williamow/mini-scanning-microscope/(list of files, cad)

Other CAD files:
optics chassis/adjustable_collimator.ipt
optics chassis/aperature clip.ipt
optics chassis/focus mount.ipt
optics chassis/objective.ipt
optics chassis/round dichroic holder.ipt
optics chassis/scan lens.ipt
optics chassis/tactic2 chassis2.ipt
