williamow/mini-scanning-microscope/boards/LD mount pcb/LD mount.kicad_pcb

## KiCad design boards/LD mount pcb/LD mount.kicad_pcb (2025-09-03)

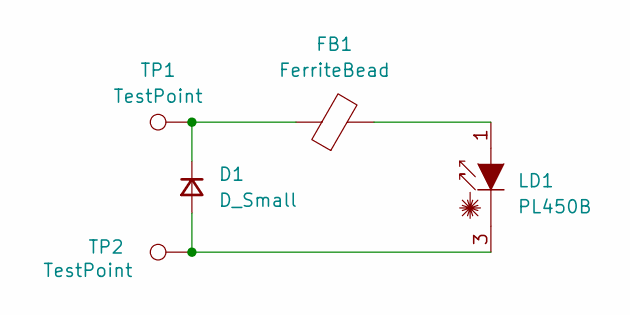
[picture p1: schematic LD mount.kicad_sch]

Parts:
D1: D_Small; D_SOD-123F
FB1: FerriteBead; L_0603_1608Metric_Pad1.05x0.95mm_HandSolder
LD1: PL450B; LaserDiode_TO38ICut-3
TP1, TP2: TestPoint; TestPoint_Pad_D2.0mm

Connections:
unnamed: D1.2 (A), LD1.3 (C), TP2.1
unnamed: D1.1 (K), FB1.1, TP1.1
unnamed: FB1.2, LD1.1 (A)

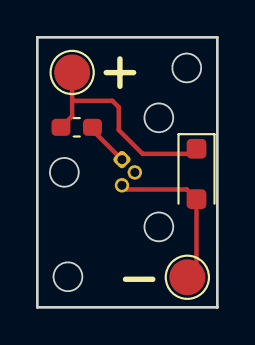
[picture p2: board LD mount.kicad_pcb from above]

Board: 2 copper layers, 10.0 x 15.0 mm, 5 parts (1 on the bottom side), 3 nets.
