williamow/mini-scanning-microscope/boards/macro system v2 pcb/controller test board.kicad_pcb

## KiCad design boards/macro system v2 pcb/controller test board.kicad_pcb (2024-10-22)

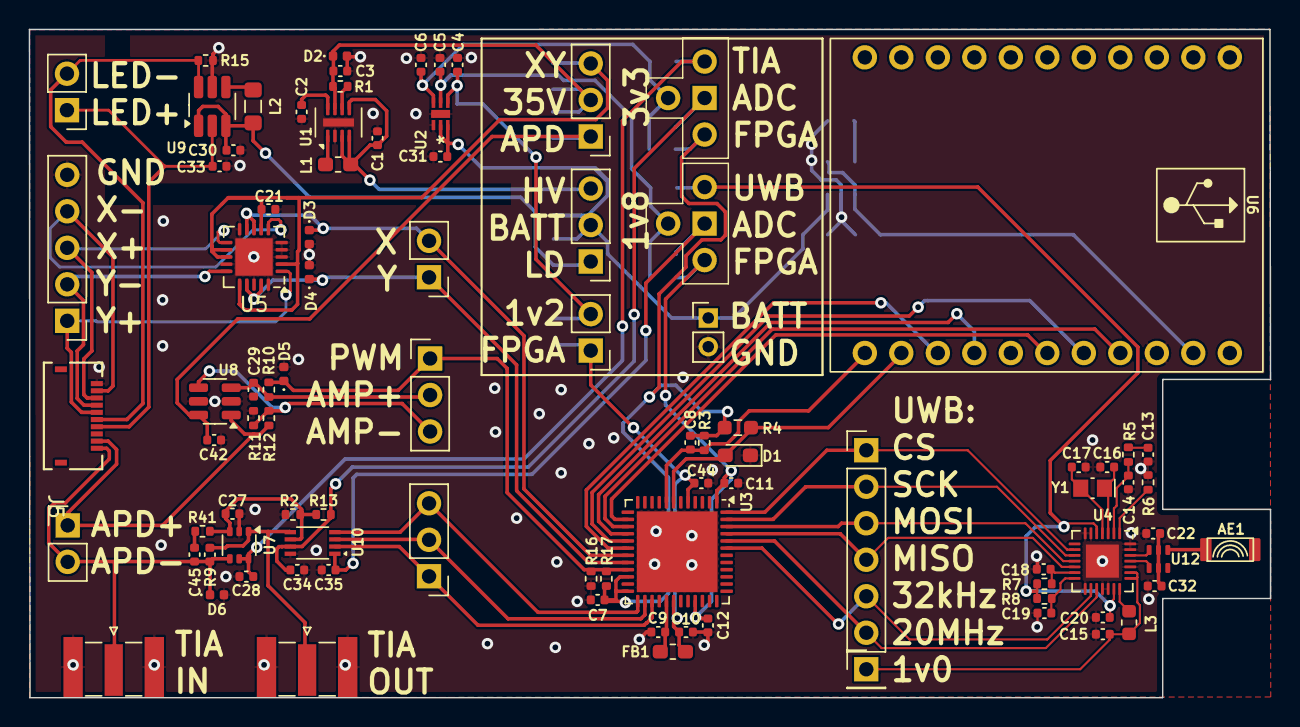
[picture p3: board boards/macro system v2 pcb/controller test board.kicad_pcb from above]

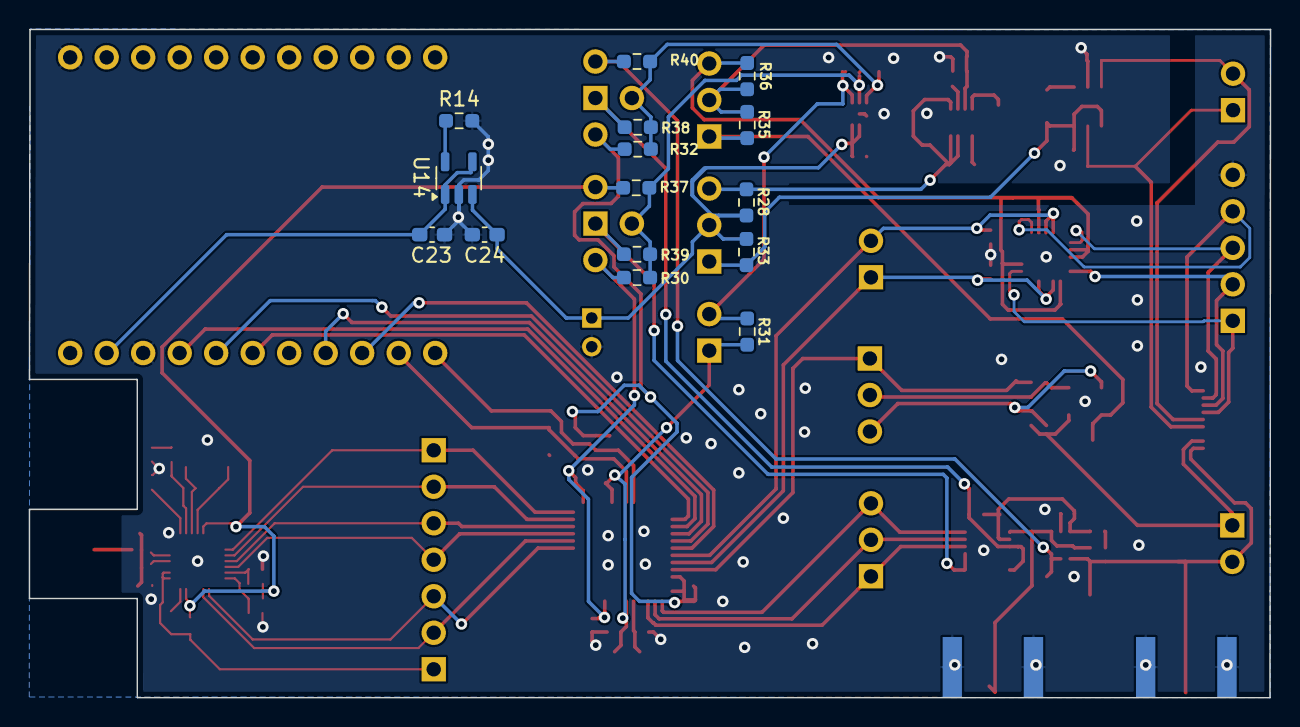
[picture p4: board boards/macro system v2 pcb/controller test board.kicad_pcb from below]

Board: 2 copper layers, 86.4 x 46.5 mm, 106 parts (15 on the bottom side), 69 nets.

Parts:
AE1: Antenna; antenna_footprint
C1, C3, C4, C5, C6, C15, C30, C31, C33: 1u; C_0402_1005Metric
C2: 0.22u; C_0402_1005Metric
C7, C9, C10, C11, C12, C18, C19, C20, C21, C22, C27, C28, C29, C32, C34, C35, C42, C44: 100n; C_0402_1005Metric
C8: 12p; C_0402_1005Metric
C13: 680p; C_0402_1005Metric
C14: 68p; C_0402_1005Metric
C16, C17: 3.9p; C_0402_1005Metric
C23, C24: 1u; C_0603_1608Metric_Pad1.08x0.95mm_HandSolder
C45: 50p; C_0402_1005Metric
D1: LED; LED_0603_1608Metric_Pad1.05x0.95mm_HandSolder
D2, D3, D4, D5, D6: D; D_0402_1005Metric
FB1: FerriteBead_Small; L_0603_1608Metric_Pad1.05x0.95mm_HandSolder
J1: Conn_01x02; PinHeader_1x02_P2.00mm_Vertical
J2, J6, J10, J11: Conn_01x03; PinHeader_1x03_P2.54mm_Vertical
J3, J14: Conn_Coaxial; SMA_Samtec_SMA-J-P-X-ST-EM1_EdgeMount
J4: Conn_01x06; PinHeader_1x06_P2.54mm_Vertical
J5: FH19C-10S-0.5SH10; CONN_FH19C-10S-0.5SH10_HIR
J7: Mirror drive; PinHeader_1x05_P2.54mm_Vertical
J8: mdrive; PinHeader_1x02_P2.54mm_Vertical
J9: APD_conn; PinHeader_1x02_P2.54mm_Vertical
J12: Conn_01x02; PinHeader_1x02_P2.54mm_Vertical
J15: LED conn; PinHeader_1x02_P2.54mm_Vertical
J16: Conn_01x01; PinHeader_1x01_P2.54mm_Vertical
L1: 15u; L_0603_1608Metric_Pad1.05x0.95mm_HandSolder
L2: 4.7u; L_0805_2012Metric_Pad1.05x1.20mm_HandSolder
L3: 180n; L_0603_1608Metric
R1: 5M; R_0402_1005Metric
R2, R10, R11, R13: 100k; R_0402_1005Metric
R3, R16, R17: 10k; R_0402_1005Metric
R4: 1k; R_0603_1608Metric_Pad0.98x0.95mm_HandSolder
R5: 390k; R_0402_1005Metric
R6: 2.2M; R_0402_1005Metric
R7: 380k; R_0402_1005Metric
R8: 0; R_0402_1005Metric
R9: TIA_FB; C_0402_1005Metric
R12: 1.2M; R_0402_1005Metric
R14: 10k; R_0603_1608Metric_Pad0.98x0.95mm_HandSolder
R15: 4.7; R_0402_1005Metric
R28, R30, R31, R32, R33, R35, R36, R37, R38, R39, R40: 1; R_0603_1608Metric_Pad0.98x0.95mm_HandSolder
R41: 50; R_0402_1005Metric
U1: LT3494; DFN-8-1EP_2x3mm_P0.5mm_EP0.56x2.15mm
U2: MIC5387-SG4YMT-TR; MLF-6_MT_MCH
U3: ICE40UP5K-SG48ITR; QFN-48-1EP_7x7mm_P0.5mm_EP5.6x5.6mm
U4: SR10x0; QFN-28-1EP_4x4mm_P0.4mm_EP2.3x2.3mm
U5: ADG5234_QFN; QFN-20-1EP_4x4mm_P0.5mm_EP2.6x2.6mm
U6: adafruit_FT232H
U7: OPA838SIDCKT; SOT-363_SC-70-6
U8: ADA4097; TSOT-23-6
U9: AP3036B; SOT-23-6_Handsoldering
U10: ADS7040xDCU; VSSOP-8_2.3x2mm_P0.5mm
U11, U13: Pin-T
U12: CSP_BALUN
U14: MCP73812T-420I-OT; SOT-23-5
Y1: 32.768kHz; Crystal_SMD_MicroCrystal_CM9V-T1A-2Pin_1.6x1.0mm_HandSolder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

Connections:
/1v2: C4.1, J12.2, R31.1, U2.4 (OUT3)
/1v8: C5.1, R30.1, R37.1, R39.2, U2.5 (OUT2), U13.3
/3v3: C6.1, R32.2, R38.2, R40.1, U2.6 (OUT1), U11.3
/35v: C3.1, D2.1 (K), J10.2, R1.2, R35.1, R36.1, U1.7 (VOUT)
/ADC/CS: J6.3, U3.25 (IOT_36b), U10.4 (~CS)
/ADC/SCLK: J6.1, U3.27 (IOT_38b), U10.2 (SCLK)
/ADC/SDO: J6.2, U3.26 (IOT_39a), U10.3 (SDO)
/ADC/ref: C27.1, R2.1, R13.1, R41.2, U7.3 (+), U10.6 (AINP)
/ADC/vin: J3.1 (In), R9.2, U7.1, U10.5 (AINM)
/ADG5234/INX: D3.1 (K), J8.2, U3.19 (IOB_29b), U5.8 (IN2), U5.9 (IN3)
/ADG5234/INY: D4.1 (K), J8.1, U3.20 (IOB_25b_G3), U5.17 (IN4), U5.19 (IN1)
/ADG5234/X+: J5.3, J7.3, U5.11 (D3)
/ADG5234/X-: J5.2, J7.4, U5.6 (D2)
/ADG5234/Y+: J5.5, J7.1, U5.1 (D1)
/ADG5234/Y-: J5.4, J7.2, U5.15 (D4)
/BATT: C24.1, C31.1, J1.1, J2.2, R28.1, R33.1, U2.2 (VIN), U2.3 (EN2/3), U14.3 (V_{BAT})
/HVbias/HV_bias: J5.9, J9.1, R12.2, U8.1
/HVbias/PWM_in: D5.1 (K), J11.1, R10.1, R16.1, R17.2, U3.21 (IOB_23b)
/ICE40UP5K/CLK_20.48M: J4.6, U3.44 (IOB_3b_G6), U4.17 (PLL_CLK)
/ICE40UP5K/CLK_32.768K: J4.5, U3.43 (IOT_49a), U4.16 (XTAL_CLK)
/ICE40UP5K/PROG_CDONE: D1.2 (A), R4.2, U3.7 (CDONE), U6.13 (CS4/D6)
/ICE40UP5K/PROG_CRESET: C8.2, R3.2, U3.8 (~CRESET), U6.12 (CS5/D7)
/ICE40UP5K/PROG_CS: U3.16 (IOB_35b_SPI_SS), U6.15 (CS2/D4)
/ICE40UP5K/PROG_CS2: U3.18 (IOB_31b), U6.14 (CS3/D5)
/ICE40UP5K/PROG_MISO: U3.14 (IOB_32a_SPI_SO), U6.17 (MISO/D2)
/ICE40UP5K/PROG_MOSI: U3.17 (IOB_33b_SPI_SI), U6.18 (MOSI/D1)
/ICE40UP5K/PROG_SCK: U3.15 (IOB_34a_SPI_SCK), U6.19 (SCK/D0)
/ICE40UP5K/UWB_CS: J4.1, U3.48 (IOB_4a), U4.9 (CSN)
/ICE40UP5K/UWB_MISO: J4.4, U3.45 (IOB_5b), U4.12 (MISO)
/ICE40UP5K/UWB_MOSI: J4.3, U3.46 (IOB_0a), U4.11 (MOSI)
/ICE40UP5K/UWB_SCK: J4.2, U3.47 (IOB_2a), U4.10 (SCK)
/I_35V_BATT: C1.1, J2.3, L1.1, R28.2, U1.3 (VCC), U1.4 (CTRL), U1.5 (EN)
/I_ADC_1V8: C35.1, R39.1, U10.1 (DVDD), U13.1
/I_ADC_3V3: C34.1, R13.2, R38.1, U10.7 (AVDD), U11.1
/I_FPGA_1V2: C10.1, C44.1, FB1.1, J12.1, R31.2, U3.5 (VCC), U3.30 (VCC)
/I_FPGA_1V8: C11.1, C12.1, R30.2, U3.1 (VCCIO_2), U3.33 (VCCIO_0), U13.4
/I_FPGA_3V3: C7.1, C8.1, R3.1, R4.1, R17.1, R32.1, U3.22 (SPI_VCCIO1), U3.24 (VPP_2V5), U11.4
/I_LED_BATT: C30.1, J2.1, L2.2, R33.2, U9.1 (EN), U9.3 (VIN)
/I_MIRROR_35V: C21.1, J10.3, R36.2, U5.2 (S1B), U5.7 (S2A), U5.12 (S3B), U5.13 (VDD), U5.16 (S4A)
/I_SPAD_35V: C42.1, J10.1, R35.2, U8.6 (V+)
/I_TIA_3V3: C28.1, R40.2, U7.5 (~DISABLE), U7.6 (V+), U11.2
/I_UWB_1V8: C20.1, R7.2, R8.1, R37.2, U4.5 (AVDD_3V), U4.20 (DVDD_3V), U13.2
/LED_driver/LED+: C33.1, J5.7, J15.1, U9.2 (VOUT)
/LED_driver/LED-: J5.6, J15.2, R15.2, U9.6 (FB)
/LT3494_boost/FB: R1.1, U1.6 (FB)
/SR1010_UWB/RFN: U4.25 (RFN), U12.4 (DIFFP)
/SR1010_UWB/RFP: U4.26 (RFP), U12.3 (DIFFN)
/TIA/I_APD: C45.2, D6.1 (K), J5.10, J9.2, J14.1 (In), R9.1, U7.4 (-)
GND: C1.2, C2.2, C3.2, C4.2, C5.2, C6.2, C7.2, C9.2, C10.2, C11.2, C12.2, C13.2, C14.2, C15.2, C16.2, C17.2, C18.2, C19.2, C20.2, C21.2, C22.2, C23.2, C24.2, C27.2, C28.2, C29.2, C30.2, C31.2, C32.2, C33.2, C34.2, C35.2, C42.2, C44.2, D1.1 (K), D2.2 (A), D3.2 (A), D4.2 (A), D5.2 (A), D6.2 (A), J1.2, J3.2 (Ext), J5.1, J7.5, J14.2 (Ext), R2.2, R6.1, R11.1, R14.1, R15.1, R16.2, U1.2 (GND), U1.9 (PAD), U2.1 (GND), U2.7 (PAD), U3.49 (GND), U4.6 (GND), U4.7 (SHUTDOWN), U4.15 (DVDD_NVM), U4.18 (SCAN_EN), U4.19 (DBG_EN), U4.24 (GND), U4.27 (GND), U4.28 (GND), U4.29 (PAD), U5.3 (VSS), U5.4 (GND), U5.5 (S2B), U5.10 (S3A), U5.14 (S4B), U5.18 (ENn), U5.20 (S1A), U5.21 (EP), U6.1 (GND), U6.20 (GND), U7.2 (V-), U8.2 (V-), U8.5 (~DISABLE), U9.5 (GND), U10.8 (GND), U14.2 (V_{SS})
unnamed: AE1.1 (A), U12.1 (SE(50))
unnamed: C13.1, R5.1
unnamed: C22.1, C32.1, U12.2 (GND), U12.5 (GND)
unnamed: C45.1, R41.1
unnamed: C29.1, J11.2, R10.2, U8.3 (+)
unnamed: J11.3, R11.2, R12.1, U8.4 (-)
unnamed: C15.1, J16.1, L3.1, U4.22 (DVDD_1V), U4.23 (AVDD_1V)
unnamed: C2.1, U1.8 (CAP)
unnamed: L1.2, U1.1 (SW)
unnamed: C9.1, FB1.2, U3.29 (VCCPLL)
unnamed: R6.2, U4.1 (BIAS)
unnamed: C19.1, R8.2, U4.14 (DVDD_1V8)
unnamed: C14.1, R5.2, U4.2 (PLL_TUNE)
unnamed: L3.2, U4.21 (REG_OUT)
unnamed: C18.1, R7.1, U4.13 (RSTN)
unnamed: C16.1, U4.3 (XTAL_C1), Y1.1
unnamed: C17.1, U4.4 (XTAL_C2), Y1.2
unnamed: L2.1, U9.4 (SW)
unnamed: C23.1, U6.21 (5V), U14.1 (CE), U14.4 (V_{DD})
unnamed: R14.2, U14.5 (PROG)
