williamow/mini-scanning-microscope/boards/LD APD M mount pcb/LD APD M mount.kicad_pcb

## KiCad design boards/LD APD M mount pcb/LD APD M mount.kicad_pcb (2024-10-22)

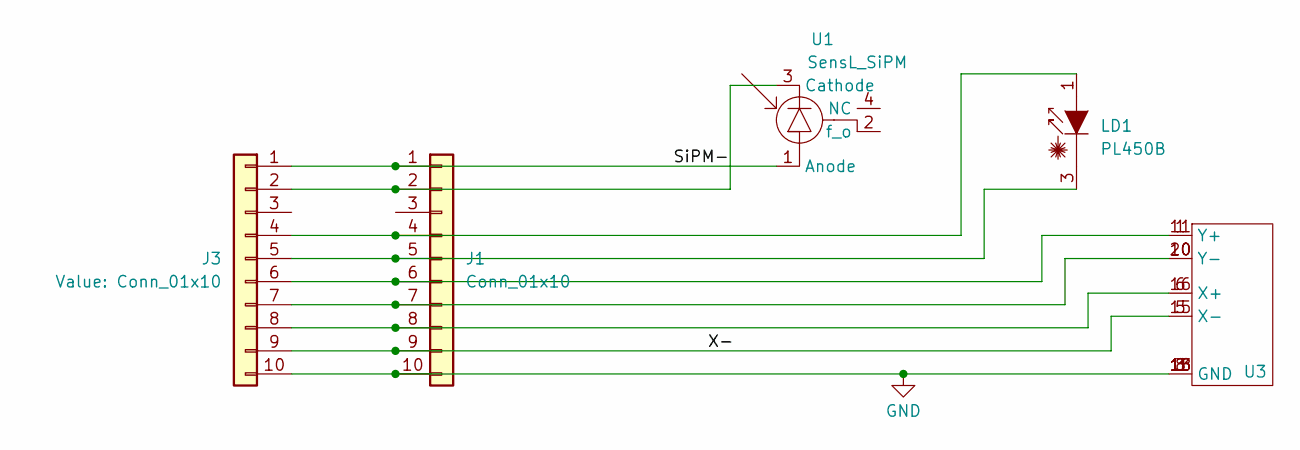
[picture p5: schematic LD APD M mount.kicad_sch]

Parts:
J1: Conn_01x10; PinHeader_1x10_P2.54mm_Vertical
J3: Conn_01x10; FH19C_Connector
LD1: PL450B; LaserDiode_TO38ICut-3
U1: SensL_SiPM; SensL_SiPM_6mm
U3: PLCC-20

Connections:
/SiPM-: J1.1, J3.1, U1.1 (Anode)
/X-: J1.9, J3.9, U3.5 (X-), U3.15 (X-)
GND: J1.10, J3.10, U3.3 (GND), U3.8 (GND), U3.13 (GND), U3.18 (GND)
unnamed: J1.2, J3.2, U1.3 (Cathode)
unnamed: J1.4, J3.4, LD1.1 (A)
unnamed: J1.5, J3.5, LD1.3 (C)
unnamed: J1.6, J3.6, U3.1 (Y+), U3.11 (Y+)
unnamed: J1.7, J3.7, U3.10 (Y-), U3.20 (Y-)
unnamed: J1.8, J3.8, U3.6 (X+), U3.16 (X+)

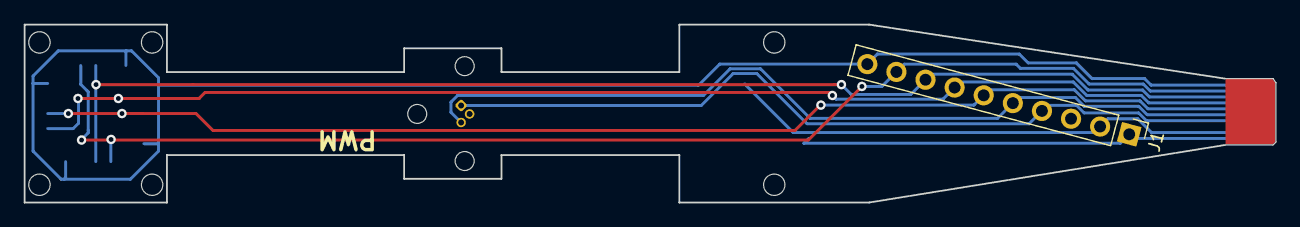
[picture p6: board LD APD M mount.kicad_pcb from above]

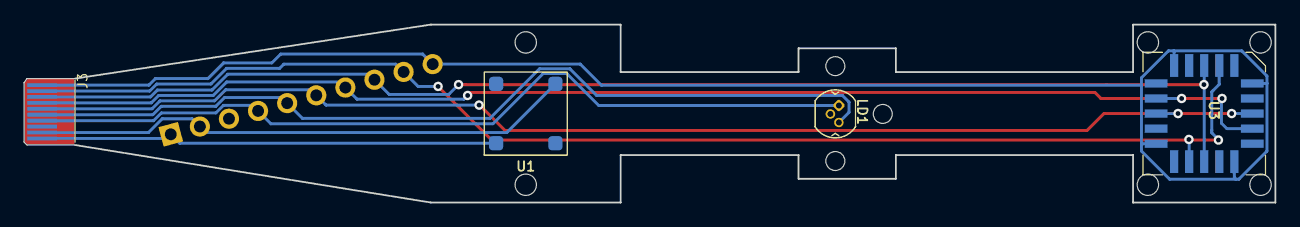
[picture p7: board LD APD M mount.kicad_pcb from below]

Board: 2 copper layers, 105.5 x 15.0 mm, 5 parts (4 on the bottom side), 9 nets.
