williamow/mini-scanning-microscope/boards/UWB antenna test pcb/UWB_antenna_tests.kicad_pcb

## KiCad design boards/UWB antenna test pcb/UWB_antenna_tests.kicad_pcb (2024-07-01)

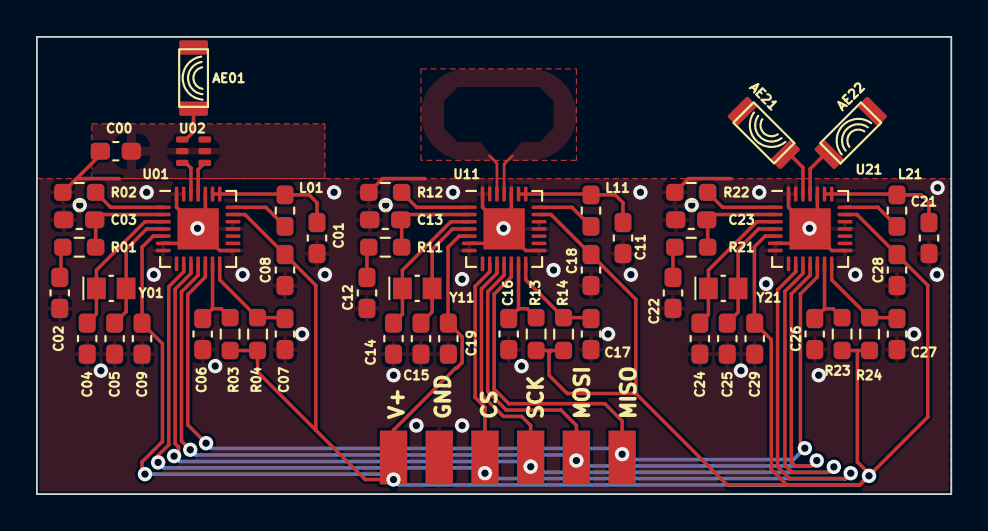
[picture p8: board UWB_antenna_tests.kicad_pcb from above]

Board: 2 copper layers, 50.8 x 25.4 mm, 59 parts (0 on the bottom side), 40 nets.

Parts:
AE01, AE21, AE22: Antenna; antenna_footprint
C00, C06, C07, C08, C09, C16, C17, C18, C19, C26, C27, C28, C29: 100n; C_0603_1608Metric_Pad1.08x0.95mm_HandSolder
C01, C11, C21: 1u; C_0603_1608Metric_Pad1.08x0.95mm_HandSolder
C02, C12, C22: 680p; C_0603_1608Metric_Pad1.08x0.95mm_HandSolder
C03, C13, C23: 68p; C_0603_1608Metric_Pad1.08x0.95mm_HandSolder
C04, C05, C14, C15, C24, C25: 3.9p; C_0603_1608Metric_Pad1.08x0.95mm_HandSolder
J1, J2, J3, J4, J5, J6: Conn_01x01; modular_pinhead_SMD
L01, L11, L21: 180n; L_0603_1608Metric_Pad1.05x0.95mm_HandSolder
R01, R11, R21: 390k; R_0603_1608Metric_Pad0.98x0.95mm_HandSolder
R02, R12, R22: 2.2M; R_0603_1608Metric_Pad0.98x0.95mm_HandSolder
R03, R13, R23: 380k; R_0603_1608Metric_Pad0.98x0.95mm_HandSolder
R04, R14, R24: 0; R_0603_1608Metric_Pad0.98x0.95mm_HandSolder
U01, U11, U21: SR10x0; QFN-28-1EP_4x4mm_P0.4mm_EP2.3x2.3mm
U02: CSP_BALUN
Y01, Y11, Y21: 32.768kHz; Crystal_SMD_MicroCrystal_CM9V-T1A-2Pin_1.6x1.0mm_HandSolder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

Connections:
/UWB radio cap coupled1/1v8: C08.1, C09.1, C18.1, C19.1, C28.1, C29.1, J1.1, R03.2, R04.1, R13.2, R14.1, R23.2, R24.1, U01.5 (AVDD_3V), U01.20 (DVDD_3V), U11.5 (AVDD_3V), U11.20 (DVDD_3V), U21.5 (AVDD_3V), U21.20 (DVDD_3V)
/UWB radio cap coupled1/CS: J6.1, U01.9 (CSN), U11.9 (CSN), U21.9 (CSN)
/UWB radio cap coupled1/MISO: J5.1, U01.12 (MISO), U11.12 (MISO), U21.12 (MISO)
/UWB radio cap coupled1/MOSI: J3.1, U01.11 (MOSI), U11.11 (MOSI), U21.11 (MOSI)
/UWB radio cap coupled1/RFN: U01.25 (RFN), U02.4 (DIFFP)
/UWB radio cap coupled1/RFP: U01.26 (RFP), U02.3 (DIFFN)
/UWB radio cap coupled1/SCK: J4.1, U01.10 (SCK), U11.10 (SCK), U21.10 (SCK)
/UWB radio cap coupled2/RFN: U11.25 (RFN), U11.26 (RFP)
/UWB radio cap coupled3/RFN: AE22.1 (A), U21.25 (RFN)
/UWB radio cap coupled3/RFP: AE21.1 (A), U21.26 (RFP)
GND: C00.2, C01.2, C02.2, C03.2, C04.2, C05.2, C06.2, C07.2, C08.2, C09.2, C11.2, C12.2, C13.2, C14.2, C15.2, C16.2, C17.2, C18.2, C19.2, C21.2, C22.2, C23.2, C24.2, C25.2, C26.2, C27.2, C28.2, C29.2, J2.1, R02.1, R12.1, R22.1, U01.6 (GND), U01.7 (SHUTDOWN), U01.15 (DVDD_NVM), U01.18 (SCAN_EN), U01.19 (DBG_EN), U01.24 (GND), U01.27 (GND), U01.28 (GND), U01.29 (PAD), U11.6 (GND), U11.7 (SHUTDOWN), U11.15 (DVDD_NVM), U11.18 (SCAN_EN), U11.19 (DBG_EN), U11.24 (GND), U11.27 (GND), U11.28 (GND), U11.29 (PAD), U21.6 (GND), U21.7 (SHUTDOWN), U21.15 (DVDD_NVM), U21.18 (SCAN_EN), U21.19 (DBG_EN), U21.24 (GND), U21.27 (GND), U21.28 (GND), U21.29 (PAD)
unnamed: AE01.1 (A), U02.1 (SE(50))
unnamed: C00.1, U02.2 (GND), U02.5 (GND)
unnamed: C01.1, L01.1, U01.22 (DVDD_1V), U01.23 (AVDD_1V)
unnamed: C02.1, R01.1
unnamed: C03.1, R01.2, U01.2 (PLL_TUNE)
unnamed: C04.1, U01.3 (XTAL_C1), Y01.1
unnamed: C05.1, U01.4 (XTAL_C2), Y01.2
unnamed: C06.1, R03.1, U01.13 (RSTN)
unnamed: C07.1, R04.2, U01.14 (DVDD_1V8)
unnamed: C11.1, L11.1, U11.22 (DVDD_1V), U11.23 (AVDD_1V)
unnamed: C12.1, R11.1
unnamed: C13.1, R11.2, U11.2 (PLL_TUNE)
unnamed: C14.1, U11.3 (XTAL_C1), Y11.1
unnamed: C15.1, U11.4 (XTAL_C2), Y11.2
unnamed: C16.1, R13.1, U11.13 (RSTN)
unnamed: C17.1, R14.2, U11.14 (DVDD_1V8)
unnamed: C21.1, L21.1, U21.22 (DVDD_1V), U21.23 (AVDD_1V)
unnamed: C22.1, R21.1
unnamed: C23.1, R21.2, U21.2 (PLL_TUNE)
unnamed: C24.1, U21.3 (XTAL_C1), Y21.1
unnamed: C25.1, U21.4 (XTAL_C2), Y21.2
unnamed: C26.1, R23.1, U21.13 (RSTN)
unnamed: C27.1, R24.2, U21.14 (DVDD_1V8)
unnamed: L01.2, U01.21 (REG_OUT)
unnamed: L11.2, U11.21 (REG_OUT)
unnamed: L21.2, U21.21 (REG_OUT)
unnamed: R02.2, U01.1 (BIAS)
unnamed: R12.2, U11.1 (BIAS)
unnamed: R22.2, U21.1 (BIAS)
