williamow/mini-scanning-microscope/boards/macro system pcb/controller test board.kicad_pcb

## KiCad design boards/macro system pcb/controller test board.kicad_pcb (2024-07-01, an earlier design)

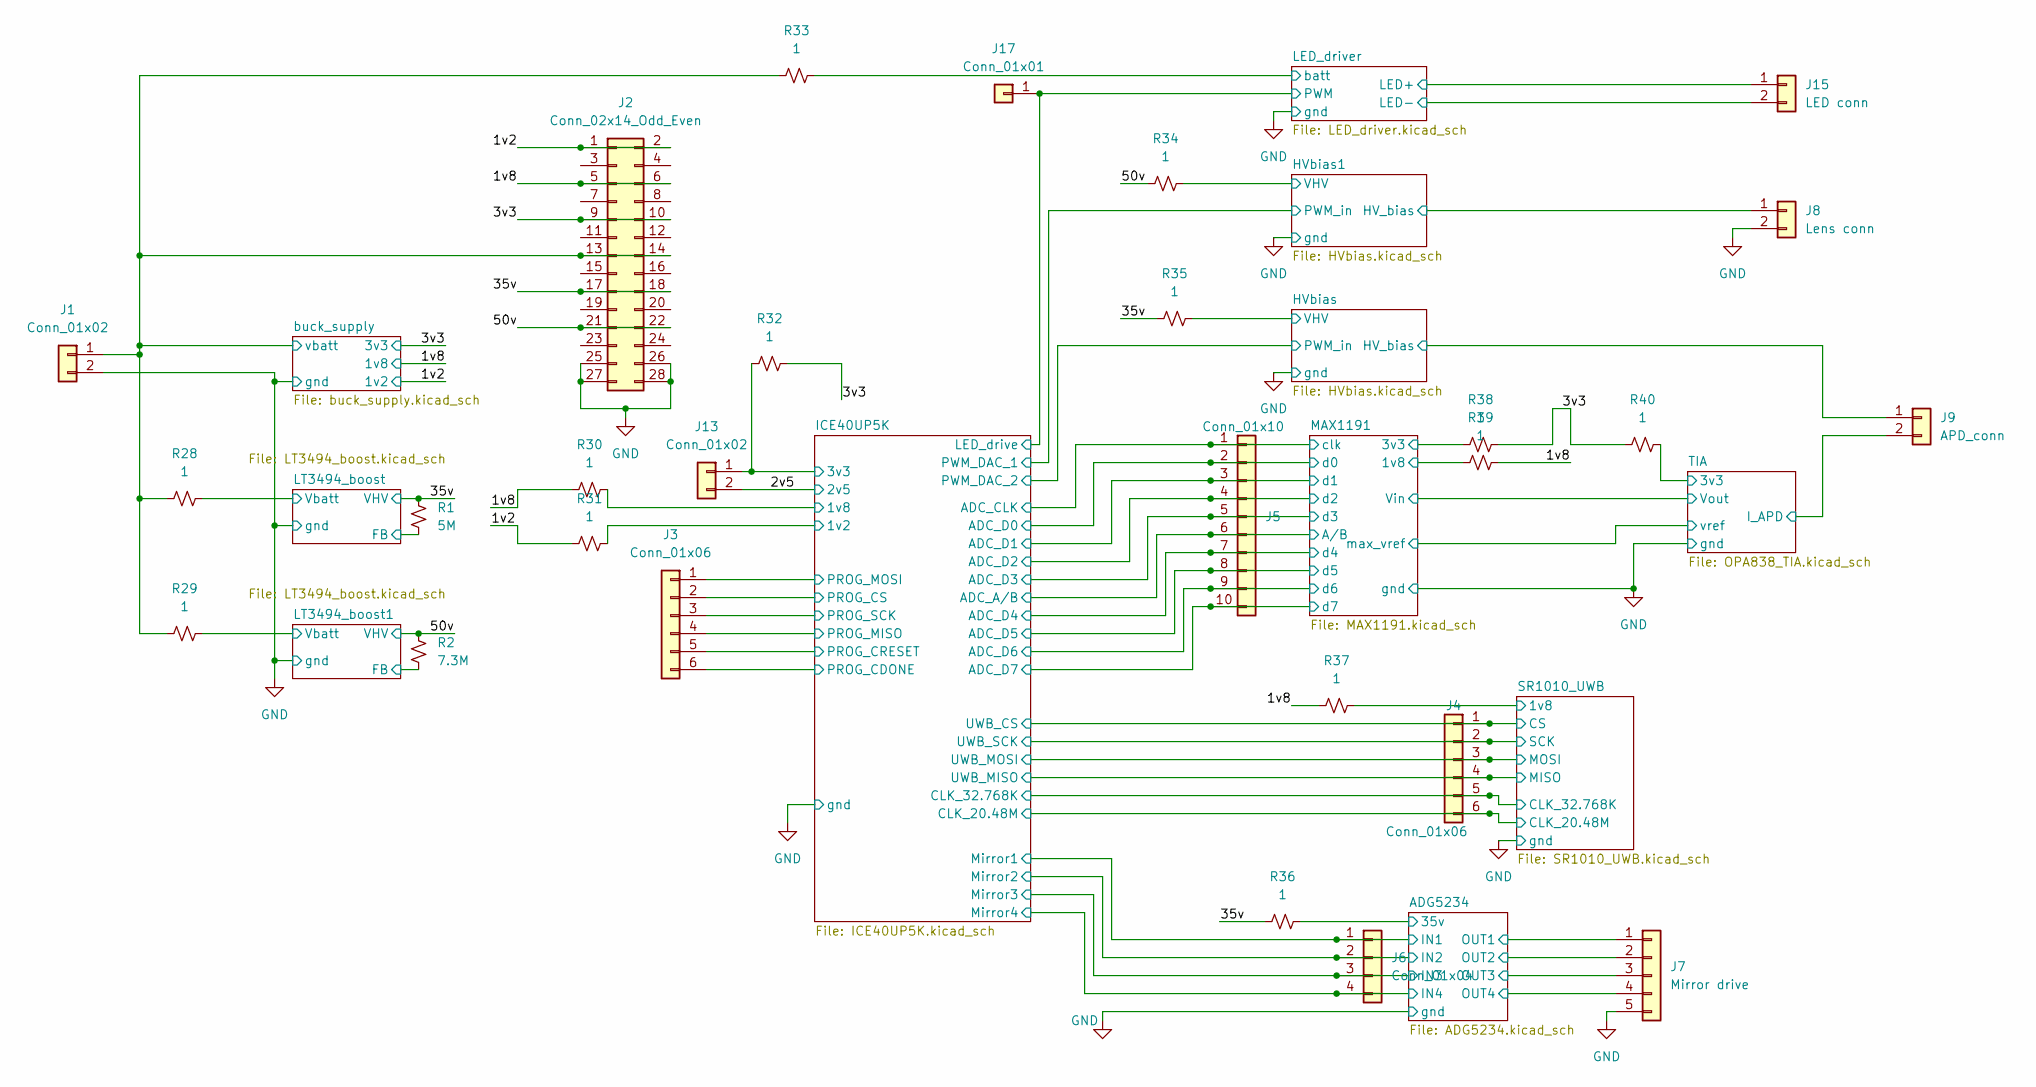
[picture p9: schematic controller test board.kicad_sch]

Parts:
J1, J13: Conn_01x02; PinHeader_1x02_P2.54mm_Vertical
J2: Conn_02x14_Odd_Even; PinHeader_2x14_P2.54mm_Vertical
J3, J4: Conn_01x06; PinHeader_1x06_P2.54mm_Vertical
J5: Conn_01x10; PinHeader_1x10_P2.54mm_Vertical
J6: Conn_01x04; PinHeader_1x04_P2.54mm_Vertical
J7: Mirror drive; PinHeader_1x05_P2.54mm_Vertical
J8: Lens conn; PinHeader_1x02_P2.54mm_Vertical
J9: APD_conn; PinHeader_1x02_P2.54mm_Vertical
J15: LED conn; PinHeader_1x02_P2.54mm_Vertical
J17: Conn_01x01; PinHeader_1x01_P2.54mm_Vertical
R1: 5M; R_0603_1608Metric_Pad0.98x0.95mm_HandSolder
R2: 7.3M; R_0603_1608Metric_Pad0.98x0.95mm_HandSolder
R28, R29, R30, R31, R32, R33, R34, R35, R36, R37, R38, R39, R40: 1; R_0603_1608Metric_Pad0.98x0.95mm_HandSolder

Connections:
/1v2: J2.1, J2.2, R31.1; also elsewhere on the board
/1v8: J2.5, J2.6, R30.1, R37.1, R39.2; also elsewhere on the board
/2v5: J13.2; also elsewhere on the board
/3v3: J2.9, J2.10, R32.2, R38.2, R40.1; also elsewhere on the board
/35v: J2.17, J2.18, R1.2, R35.1, R36.1; also elsewhere on the board
/50v: J2.21, J2.22, R2.2, R34.1; also elsewhere on the board
/ADG5234/35v: R36.2; also elsewhere on the board
/ADG5234/IN1: J6.1; also elsewhere on the board
/ADG5234/IN2: J6.2; also elsewhere on the board
/ADG5234/IN3: J6.3; also elsewhere on the board
/ADG5234/IN4: J6.4; also elsewhere on the board
/ADG5234/OUT1: J7.1; also elsewhere on the board
/ADG5234/OUT2: J7.2; also elsewhere on the board
/ADG5234/OUT3: J7.3; also elsewhere on the board
/ADG5234/OUT4: J7.4; also elsewhere on the board
/HVbias1/HV_bias: J8.1; also elsewhere on the board
/HVbias1/VHV: R34.2; also elsewhere on the board
/HVbias/HV_bias: J9.1; also elsewhere on the board
/HVbias/VHV: R35.2; also elsewhere on the board
/ICE40UP5K/1v2: R31.2; also elsewhere on the board
/ICE40UP5K/1v8: R30.2; also elsewhere on the board
/ICE40UP5K/3v3: J13.1, R32.1; also elsewhere on the board
/ICE40UP5K/ADC_A/B: J5.6; also elsewhere on the board
/ICE40UP5K/ADC_CLK: J5.1; also elsewhere on the board
/ICE40UP5K/ADC_D0: J5.2; also elsewhere on the board
/ICE40UP5K/ADC_D1: J5.3; also elsewhere on the board
/ICE40UP5K/ADC_D2: J5.4; also elsewhere on the board
/ICE40UP5K/ADC_D3: J5.5; also elsewhere on the board
/ICE40UP5K/ADC_D4: J5.7; also elsewhere on the board
/ICE40UP5K/ADC_D5: J5.8; also elsewhere on the board
/ICE40UP5K/ADC_D6: J5.9; also elsewhere on the board
/ICE40UP5K/ADC_D7: J5.10; also elsewhere on the board
/ICE40UP5K/CLK_20.48M: J4.6; also elsewhere on the board
/ICE40UP5K/CLK_32.768K: J4.5; also elsewhere on the board
/ICE40UP5K/LED_drive: J17.1; also elsewhere on the board
/ICE40UP5K/PROG_CDONE: J3.6; also elsewhere on the board
/ICE40UP5K/PROG_CRESET: J3.5; also elsewhere on the board
/ICE40UP5K/PROG_CS: J3.2; also elsewhere on the board
/ICE40UP5K/PROG_MISO: J3.4; also elsewhere on the board
/ICE40UP5K/PROG_MOSI: J3.1; also elsewhere on the board
/ICE40UP5K/PROG_SCK: J3.3; also elsewhere on the board
/ICE40UP5K/UWB_CS: J4.1; also elsewhere on the board
/ICE40UP5K/UWB_MISO: J4.4; also elsewhere on the board
/ICE40UP5K/UWB_MOSI: J4.3; also elsewhere on the board
/ICE40UP5K/UWB_SCK: J4.2; also elsewhere on the board
/LED_driver/LED+: J15.1; also elsewhere on the board
/LED_driver/LED-: J15.2; also elsewhere on the board
/LED_driver/batt: R33.2; also elsewhere on the board
/LT3494_boost1/FB: R2.1; also elsewhere on the board
/LT3494_boost1/Vbatt: R29.2; also elsewhere on the board
/LT3494_boost/FB: R1.1; also elsewhere on the board
/LT3494_boost/Vbatt: R28.2; also elsewhere on the board
/MAX1191/1v8: R39.1; also elsewhere on the board
/MAX1191/3v3: R38.1; also elsewhere on the board
/SR1010_UWB/1v8: R37.2; also elsewhere on the board
/TIA/3v3: R40.2; also elsewhere on the board
/TIA/I_APD: J9.2; also elsewhere on the board
/buck_supply/vbatt: J1.1, J2.13, J2.14, R28.1, R29.1, R33.1; also elsewhere on the board
GND: J1.2, J2.25, J2.26, J2.27, J2.28, J7.5, J8.2; also elsewhere on the board

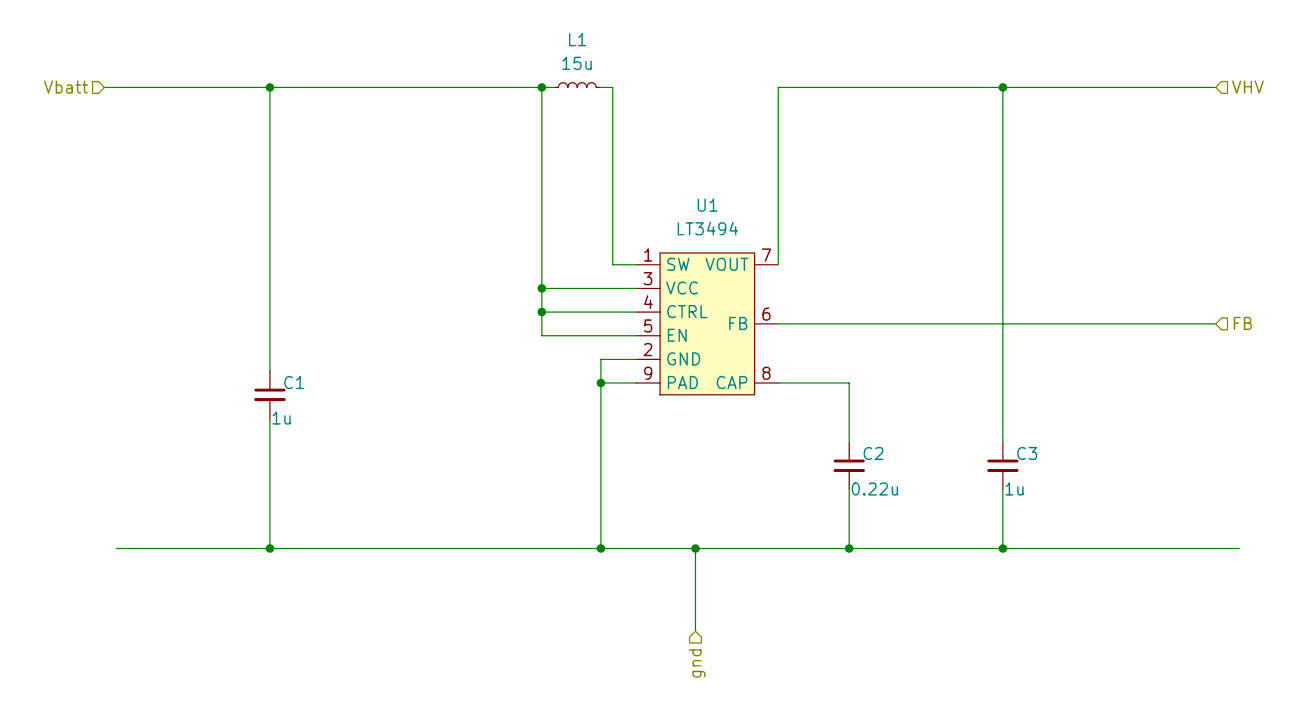
[picture p10: schematic LT3494_boost.kicad_sch]

Parts:
C1, C3: 1u; C_0603_1608Metric_Pad1.08x0.95mm_HandSolder
C2: 0.22u; C_0603_1608Metric_Pad1.08x0.95mm_HandSolder
L1: 15u; L_0603_1608Metric_Pad1.05x0.95mm_HandSolder
U1: LT3494; DFN-8-1EP_2x3mm_P0.5mm_EP0.56x2.15mm

Connections:
/35v: C3.1, U1.7 (VOUT); also elsewhere on the board
/LT3494_boost/FB: U1.6 (FB); also elsewhere on the board
/LT3494_boost/Vbatt: C1.1, L1.1, U1.3 (VCC), U1.4 (CTRL), U1.5 (EN); also elsewhere on the board
GND: C1.2, C2.2, C3.2, U1.2 (GND), U1.9 (PAD); also elsewhere on the board
unnamed: C2.1, U1.8 (CAP)
unnamed: L1.2, U1.1 (SW)

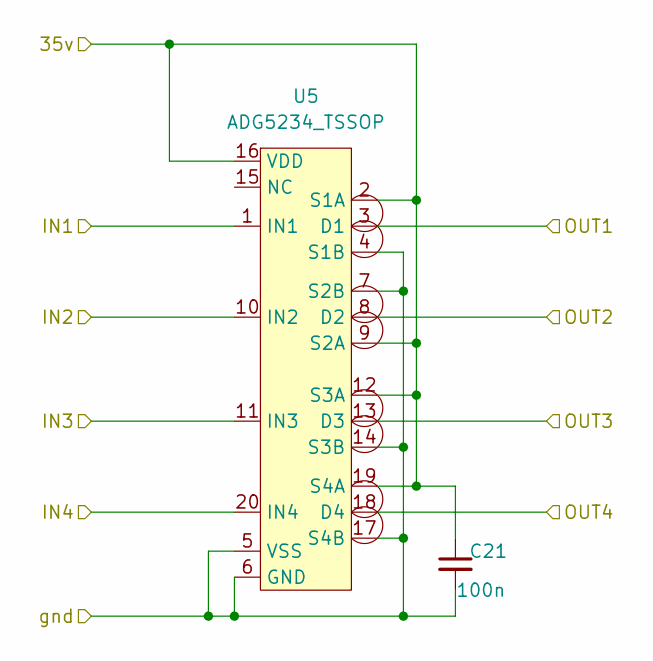
[picture p11: schematic ADG5234.kicad_sch]

Parts:
C21: 100n; C_0603_1608Metric_Pad1.08x0.95mm_HandSolder
U5: ADG5234_TSSOP; TSSOP-20_4.4x6.5mm_P0.65mm

Connections:
/ADG5234/35v: C21.1, U5.2 (S1A), U5.9 (S2A), U5.12 (S3A), U5.16 (VDD), U5.19 (S4A); also elsewhere on the board
/ADG5234/IN1: U5.1 (IN1); also elsewhere on the board
/ADG5234/IN2: U5.10 (IN2); also elsewhere on the board
/ADG5234/IN3: U5.11 (IN3); also elsewhere on the board
/ADG5234/IN4: U5.20 (IN4); also elsewhere on the board
/ADG5234/OUT1: U5.3 (D1); also elsewhere on the board
/ADG5234/OUT2: U5.8 (D2); also elsewhere on the board
/ADG5234/OUT3: U5.13 (D3); also elsewhere on the board
/ADG5234/OUT4: U5.18 (D4); also elsewhere on the board
GND: C21.2, U5.4 (S1B), U5.5 (VSS), U5.6 (GND), U5.7 (S2B), U5.14 (S3B), U5.17 (S4B); also elsewhere on the board

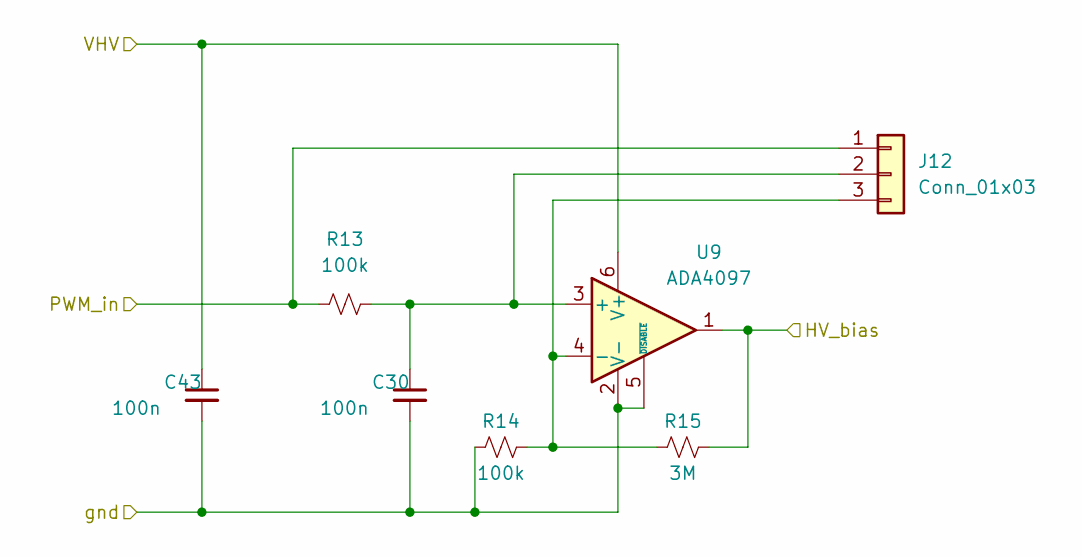
[picture p12: schematic HVbias.kicad_sch]

Parts:
C30, C43: 100n; C_0603_1608Metric_Pad1.08x0.95mm_HandSolder
J12: Conn_01x03; PinHeader_1x03_P2.54mm_Vertical
R13, R14: 100k; R_0603_1608Metric_Pad0.98x0.95mm_HandSolder
R15: 3M; R_0603_1608Metric_Pad0.98x0.95mm_HandSolder
U9: ADA4097; TSOT-23-6_HandSoldering

Connections:
/HVbias1/HV_bias: R15.2, U9.1; also elsewhere on the board
/HVbias1/PWM_in: J12.1, R13.1; also elsewhere on the board
/HVbias1/VHV: C43.1, U9.6 (V+); also elsewhere on the board
GND: C30.2, C43.2, R14.1, U9.2 (V-), U9.5 (~DISABLE); also elsewhere on the board
unnamed: C30.1, J12.2, R13.2, U9.3 (+)
unnamed: J12.3, R14.2, R15.1, U9.4 (-)

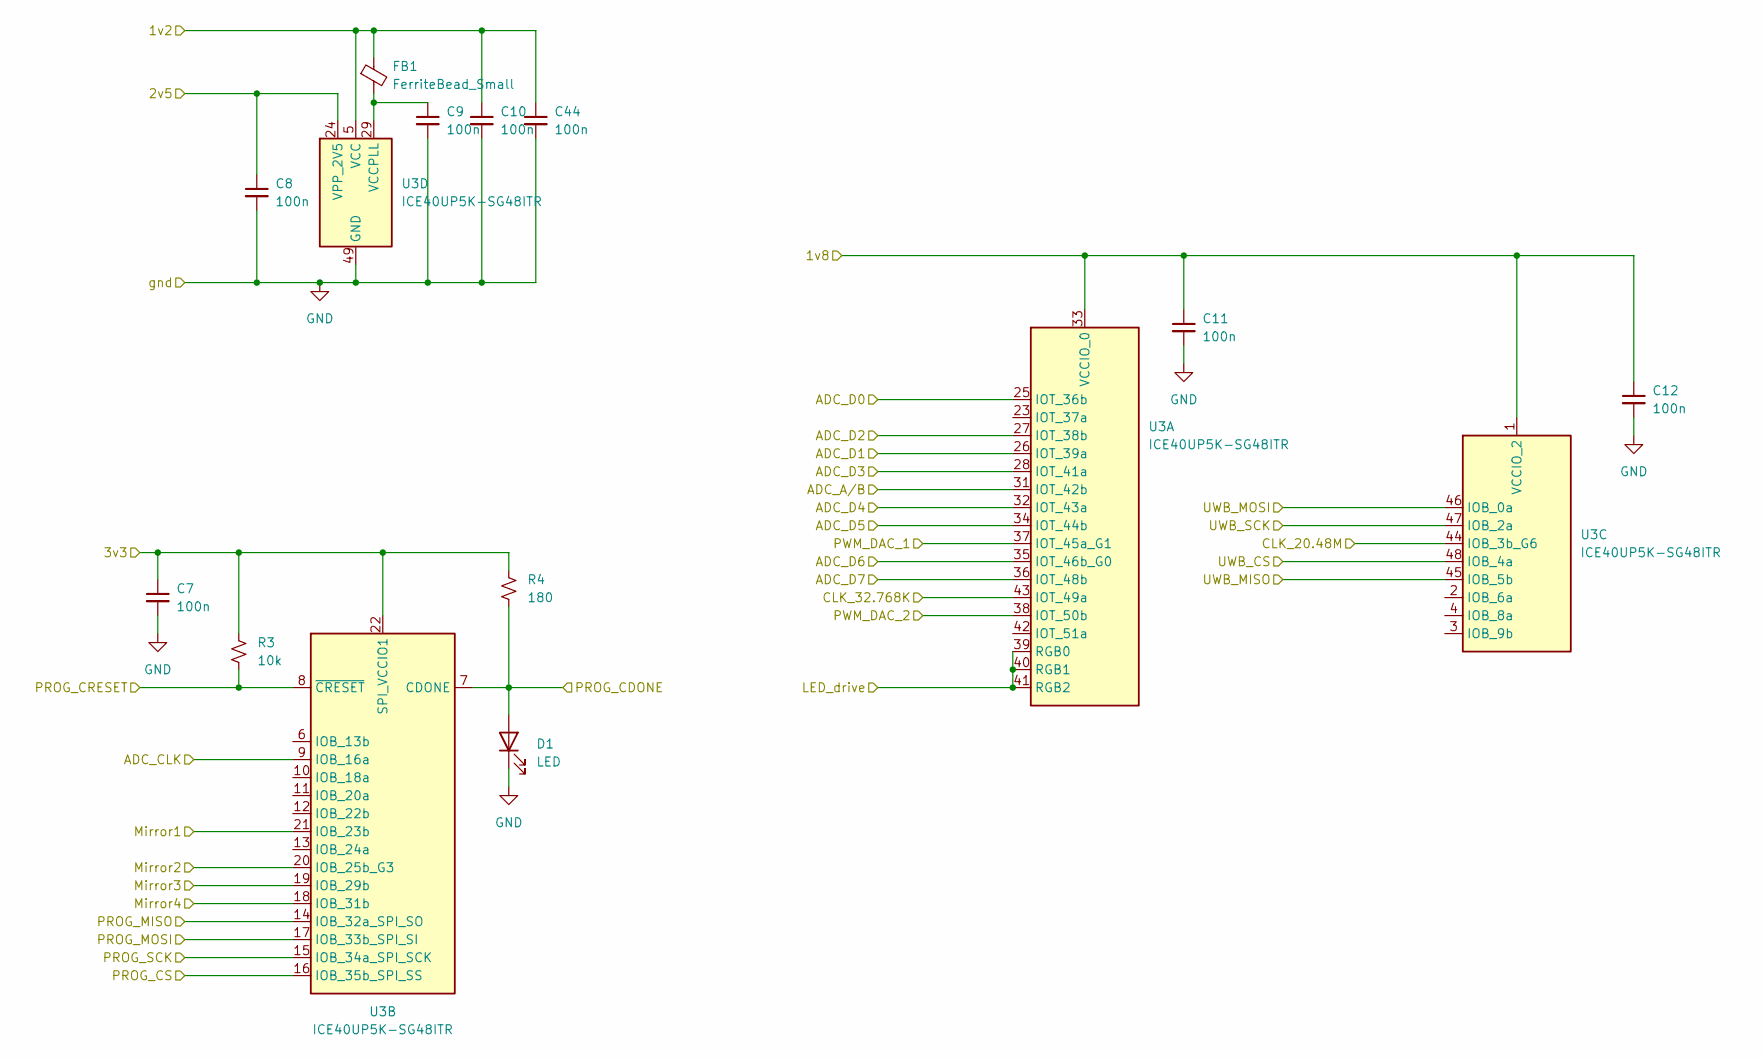
[picture p13: schematic ICE40UP5K.kicad_sch]

Parts:
C7, C8, C9, C10, C11, C12, C44: 100n; C_0603_1608Metric_Pad1.08x0.95mm_HandSolder
D1: LED; LED_0603_1608Metric_Pad1.05x0.95mm_HandSolder
FB1: FerriteBead_Small; L_0603_1608Metric_Pad1.05x0.95mm_HandSolder
R3: 10k; R_0603_1608Metric_Pad0.98x0.95mm_HandSolder
R4: 180; R_0603_1608Metric_Pad0.98x0.95mm_HandSolder
U3: ICE40UP5K-SG48ITR; QFN-48-1EP_7x7mm_P0.5mm_EP5.6x5.6mm

Connections:
/2v5: C8.1, U3.24 (VPP_2V5); also elsewhere on the board
/ADG5234/IN1: U3.21 (IOB_23b); also elsewhere on the board
/ADG5234/IN2: U3.20 (IOB_25b_G3); also elsewhere on the board
/ADG5234/IN3: U3.19 (IOB_29b); also elsewhere on the board
/ADG5234/IN4: U3.18 (IOB_31b); also elsewhere on the board
/HVbias1/PWM_in: U3.37 (IOT_45a_G1); also elsewhere on the board
/HVbias/PWM_in: U3.38 (IOT_50b); also elsewhere on the board
/ICE40UP5K/1v2: C10.1, C44.1, FB1.1, U3.5 (VCC), U3.30 (VCC); also elsewhere on the board
/ICE40UP5K/1v8: C11.1, C12.1, U3.1 (VCCIO_2), U3.33 (VCCIO_0); also elsewhere on the board
/ICE40UP5K/3v3: C7.1, R3.1, R4.1, U3.22 (SPI_VCCIO1); also elsewhere on the board
/ICE40UP5K/ADC_A/B: U3.31 (IOT_42b); also elsewhere on the board
/ICE40UP5K/ADC_CLK: U3.9 (IOB_16a); also elsewhere on the board
/ICE40UP5K/ADC_D0: U3.25 (IOT_36b); also elsewhere on the board
/ICE40UP5K/ADC_D1: U3.26 (IOT_39a); also elsewhere on the board
/ICE40UP5K/ADC_D2: U3.27 (IOT_38b); also elsewhere on the board
/ICE40UP5K/ADC_D3: U3.28 (IOT_41a); also elsewhere on the board
/ICE40UP5K/ADC_D4: U3.32 (IOT_43a); also elsewhere on the board
/ICE40UP5K/ADC_D5: U3.34 (IOT_44b); also elsewhere on the board
/ICE40UP5K/ADC_D6: U3.35 (IOT_46b_G0); also elsewhere on the board
/ICE40UP5K/ADC_D7: U3.36 (IOT_48b); also elsewhere on the board
/ICE40UP5K/CLK_20.48M: U3.44 (IOB_3b_G6); also elsewhere on the board
/ICE40UP5K/CLK_32.768K: U3.43 (IOT_49a); also elsewhere on the board
/ICE40UP5K/LED_drive: U3.39 (RGB0), U3.40 (RGB1), U3.41 (RGB2); also elsewhere on the board
/ICE40UP5K/PROG_CDONE: D1.2 (A), R4.2, U3.7 (CDONE); also elsewhere on the board
/ICE40UP5K/PROG_CRESET: R3.2, U3.8 (~CRESET); also elsewhere on the board
/ICE40UP5K/PROG_CS: U3.16 (IOB_35b_SPI_SS); also elsewhere on the board
/ICE40UP5K/PROG_MISO: U3.14 (IOB_32a_SPI_SO); also elsewhere on the board
/ICE40UP5K/PROG_MOSI: U3.17 (IOB_33b_SPI_SI); also elsewhere on the board
/ICE40UP5K/PROG_SCK: U3.15 (IOB_34a_SPI_SCK); also elsewhere on the board
/ICE40UP5K/UWB_CS: U3.48 (IOB_4a); also elsewhere on the board
/ICE40UP5K/UWB_MISO: U3.45 (IOB_5b); also elsewhere on the board
/ICE40UP5K/UWB_MOSI: U3.46 (IOB_0a); also elsewhere on the board
/ICE40UP5K/UWB_SCK: U3.47 (IOB_2a); also elsewhere on the board
GND: C7.2, C8.2, C9.2, C10.2, C11.2, C12.2, C44.2, D1.1 (K), U3.49 (GND); also elsewhere on the board
unnamed: C9.1, FB1.2, U3.29 (VCCPLL)
