williamow/mini-scanning-microscope/boards/macro system pcb/controller test board.kicad_pcb

## KiCad design boards/macro system pcb/controller test board.kicad_pcb (continued)

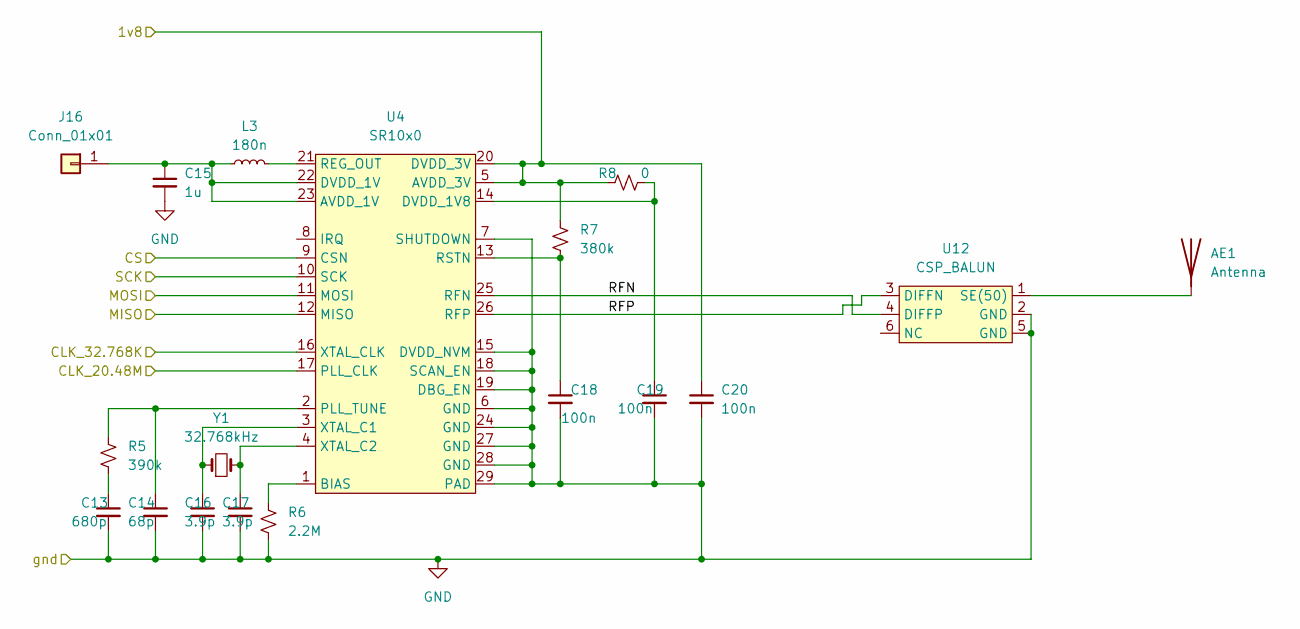
[picture p14: schematic SR1010_UWB.kicad_sch]

Parts:
AE1: Antenna; antenna_footprint
C13: 680p; C_0603_1608Metric_Pad1.08x0.95mm_HandSolder
C14: 68p; C_0603_1608Metric_Pad1.08x0.95mm_HandSolder
C15: 1u; C_0603_1608Metric_Pad1.08x0.95mm_HandSolder
C16, C17: 3.9p; C_0603_1608Metric_Pad1.08x0.95mm_HandSolder
C18, C19, C20: 100n; C_0603_1608Metric_Pad1.08x0.95mm_HandSolder
J16: Conn_01x01; PinHeader_1x01_P2.54mm_Vertical
L3: 180n; L_0603_1608Metric_Pad1.05x0.95mm_HandSolder
R5: 390k; R_0603_1608Metric_Pad0.98x0.95mm_HandSolder
R6: 2.2M; R_0603_1608Metric_Pad0.98x0.95mm_HandSolder
R7: 380k; R_0603_1608Metric_Pad0.98x0.95mm_HandSolder
R8: 0; R_0603_1608Metric_Pad0.98x0.95mm_HandSolder
U4: SR10x0; QFN-28-1EP_4x4mm_P0.4mm_EP2.3x2.3mm
U12: CSP_BALUN
Y1: 32.768kHz; Crystal_SMD_MicroCrystal_CM9V-T1A-2Pin_1.6x1.0mm_HandSolder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

Connections:
/ICE40UP5K/CLK_20.48M: U4.17 (PLL_CLK); also elsewhere on the board
/ICE40UP5K/CLK_32.768K: U4.16 (XTAL_CLK); also elsewhere on the board
/ICE40UP5K/UWB_CS: U4.9 (CSN); also elsewhere on the board
/ICE40UP5K/UWB_MISO: U4.12 (MISO); also elsewhere on the board
/ICE40UP5K/UWB_MOSI: U4.11 (MOSI); also elsewhere on the board
/ICE40UP5K/UWB_SCK: U4.10 (SCK); also elsewhere on the board
/SR1010_UWB/1v8: C20.1, R7.2, R8.1, U4.5 (AVDD_3V), U4.20 (DVDD_3V); also elsewhere on the board
/SR1010_UWB/RFN: U4.25 (RFN), U12.4 (DIFFP)
/SR1010_UWB/RFP: U4.26 (RFP), U12.3 (DIFFN)
GND: C13.2, C14.2, C15.2, C16.2, C17.2, C18.2, C19.2, C20.2, R6.1, U4.6 (GND), U4.7 (SHUTDOWN), U4.15 (DVDD_NVM), U4.18 (SCAN_EN), U4.19 (DBG_EN), U4.24 (GND), U4.27 (GND), U4.28 (GND), U4.29 (PAD), U12.2 (GND), U12.5 (GND); also elsewhere on the board
unnamed: C13.1, R5.1
unnamed: C14.1, R5.2, U4.2 (PLL_TUNE)
unnamed: C15.1, J16.1, L3.1, U4.22 (DVDD_1V), U4.23 (AVDD_1V)
unnamed: C16.1, U4.3 (XTAL_C1), Y1.1
unnamed: C17.1, U4.4 (XTAL_C2), Y1.2
unnamed: C18.1, R7.1, U4.13 (RSTN)
unnamed: C19.1, R8.2, U4.14 (DVDD_1V8)
unnamed: L3.2, U4.21 (REG_OUT)
unnamed: R6.2, U4.1 (BIAS)
unnamed: AE1.1 (A), U12.1 (SE(50))

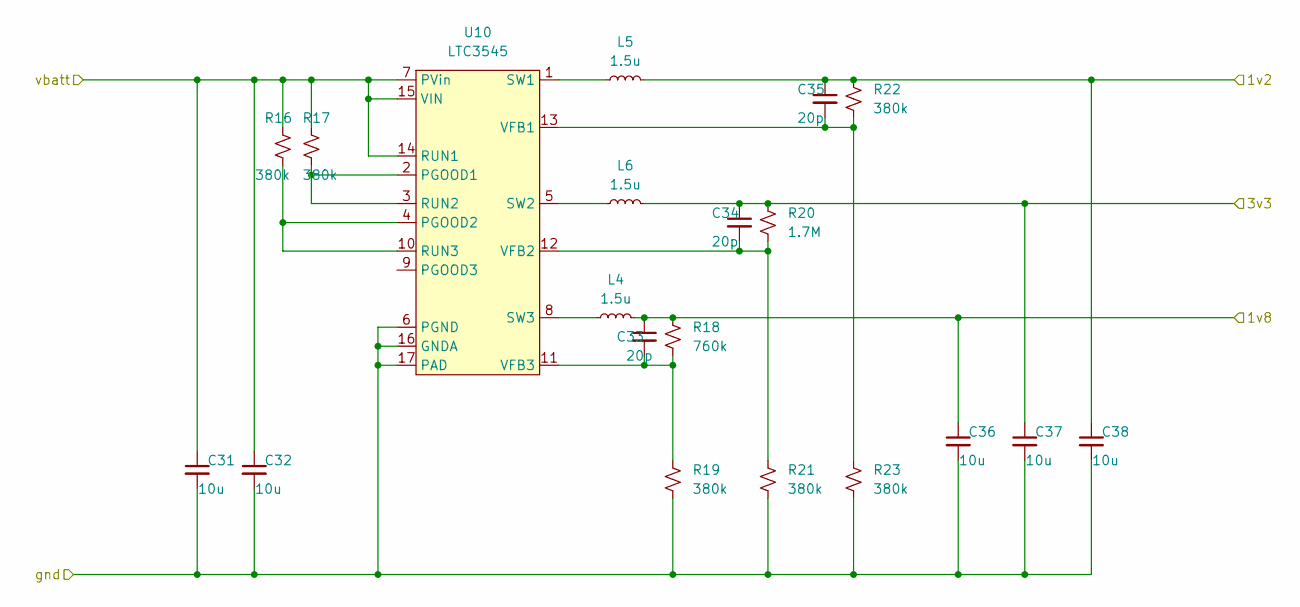
[picture p15: schematic buck_supply.kicad_sch]

Parts:
C31, C32, C36, C37, C38: 10u; C_0603_1608Metric_Pad1.08x0.95mm_HandSolder
C33, C34, C35: 20p; C_0603_1608Metric_Pad1.08x0.95mm_HandSolder
L4, L5, L6: 1.5u; L_0603_1608Metric_Pad1.05x0.95mm_HandSolder
R16, R17, R19, R21, R22, R23: 380k; R_0603_1608Metric_Pad0.98x0.95mm_HandSolder
R18: 760k; R_0603_1608Metric_Pad0.98x0.95mm_HandSolder
R20: 1.7M; R_0603_1608Metric_Pad0.98x0.95mm_HandSolder
U10: LTC3545; QFN-16-1EP_3x3mm_P0.5mm_EP1.45x1.45mm

Connections:
/1v2: C35.1, C38.1, L5.2, R22.2; also elsewhere on the board
/1v8: C33.1, C36.1, L4.2, R18.2; also elsewhere on the board
/3v3: C34.1, C37.1, L6.2, R20.2; also elsewhere on the board
/buck_supply/vbatt: C31.1, C32.1, R16.2, R17.2, U10.7 (PVin), U10.14 (RUN1), U10.15 (VIN); also elsewhere on the board
GND: C31.2, C32.2, C36.2, C37.2, C38.2, R19.1, R21.1, R23.1, U10.6 (PGND), U10.16 (GNDA), U10.17 (PAD); also elsewhere on the board
unnamed: C33.2, R18.1, R19.2, U10.11 (VFB3)
unnamed: C34.2, R20.1, R21.2, U10.12 (VFB2)
unnamed: C35.2, R22.1, R23.2, U10.13 (VFB1)
unnamed: L4.1, U10.8 (SW3)
unnamed: L5.1, U10.1 (SW1)
unnamed: L6.1, U10.5 (SW2)
unnamed: R16.1, U10.4 (PGOOD2), U10.10 (RUN3)
unnamed: R17.1, U10.2 (PGOOD1), U10.3 (RUN2)

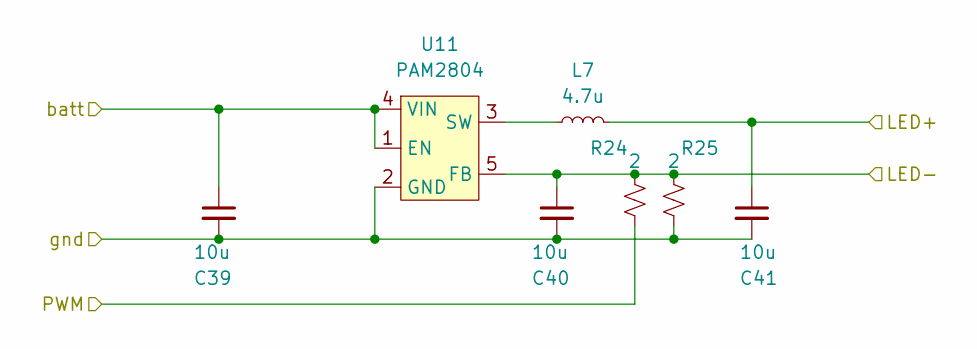
[picture p16: schematic LED_driver.kicad_sch]

Parts:
C39, C40, C41: 10u; C_0603_1608Metric_Pad1.08x0.95mm_HandSolder
L7: 4.7u; L_0805_2012Metric_Pad1.05x1.20mm_HandSolder
R24, R25: 2; R_0603_1608Metric_Pad0.98x0.95mm_HandSolder
U11: PAM2804; TSOT-23-5_HandSoldering

Connections:
/ICE40UP5K/LED_drive: R24.1; also elsewhere on the board
/LED_driver/LED+: C41.1, L7.2; also elsewhere on the board
/LED_driver/LED-: C40.1, R24.2, R25.2, U11.5 (FB); also elsewhere on the board
/LED_driver/batt: C39.1, U11.1 (EN), U11.4 (VIN); also elsewhere on the board
GND: C39.2, C40.2, C41.2, R25.1, U11.2 (GND); also elsewhere on the board
unnamed: L7.1, U11.3 (SW)

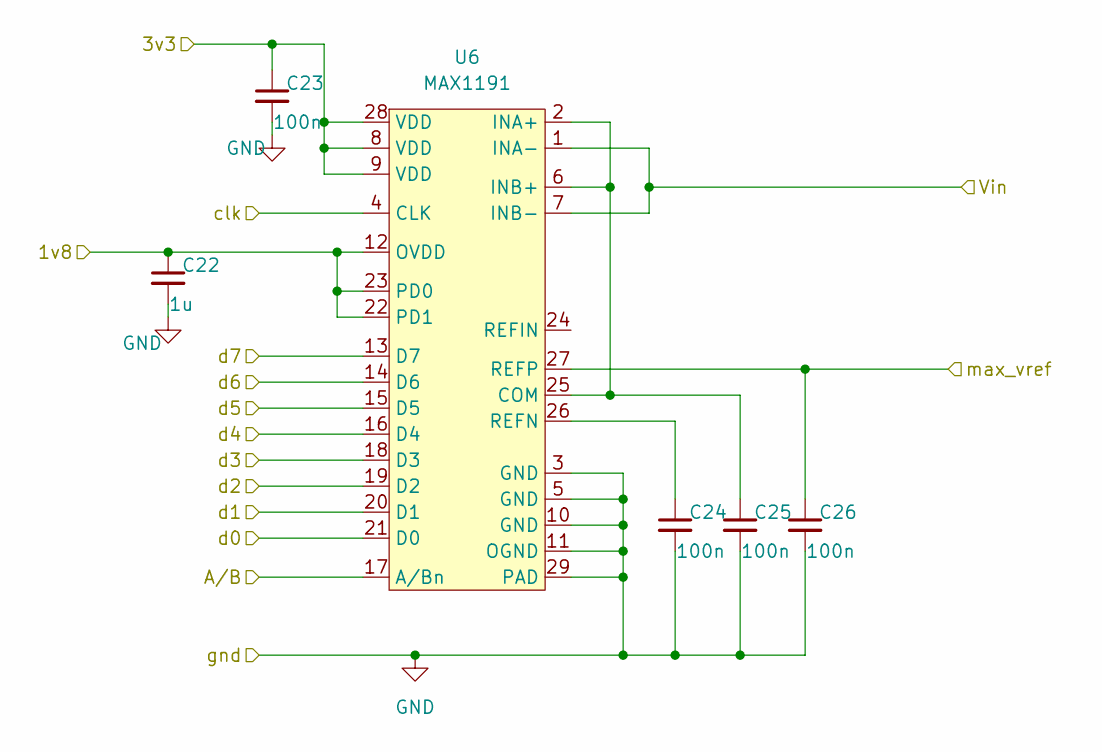
[picture p17: schematic MAX1191.kicad_sch]

Parts:
C22: 1u; C_0603_1608Metric_Pad1.08x0.95mm_HandSolder
C23, C24, C25, C26: 100n; C_0603_1608Metric_Pad1.08x0.95mm_HandSolder
U6: MAX1191; QFN-28-1EP_5x5mm_P0.5mm_EP3.35x3.35mm

Connections:
/ICE40UP5K/ADC_A/B: U6.17 (A/Bn); also elsewhere on the board
/ICE40UP5K/ADC_CLK: U6.4 (CLK); also elsewhere on the board
/ICE40UP5K/ADC_D0: U6.21 (D0); also elsewhere on the board
/ICE40UP5K/ADC_D1: U6.20 (D1); also elsewhere on the board
/ICE40UP5K/ADC_D2: U6.19 (D2); also elsewhere on the board
/ICE40UP5K/ADC_D3: U6.18 (D3); also elsewhere on the board
/ICE40UP5K/ADC_D4: U6.16 (D4); also elsewhere on the board
/ICE40UP5K/ADC_D5: U6.15 (D5); also elsewhere on the board
/ICE40UP5K/ADC_D6: U6.14 (D6); also elsewhere on the board
/ICE40UP5K/ADC_D7: U6.13 (D7); also elsewhere on the board
/MAX1191/1v8: C22.1, U6.12 (OVDD), U6.22 (PD1), U6.23 (PD0); also elsewhere on the board
/MAX1191/3v3: C23.1, U6.8 (VDD), U6.9 (VDD), U6.28 (VDD); also elsewhere on the board
/MAX1191/Vin: U6.1 (INA-), U6.7 (INB-); also elsewhere on the board
/MAX1191/max_vref: C26.1, U6.27 (REFP); also elsewhere on the board
GND: C22.2, C23.2, C24.2, C25.2, C26.2, U6.3 (GND), U6.5 (GND), U6.10 (GND), U6.11 (OGND), U6.29 (PAD); also elsewhere on the board
unnamed: C24.1, U6.26 (REFN)
unnamed: C25.1, U6.2 (INA+), U6.6 (INB+), U6.25 (COM)

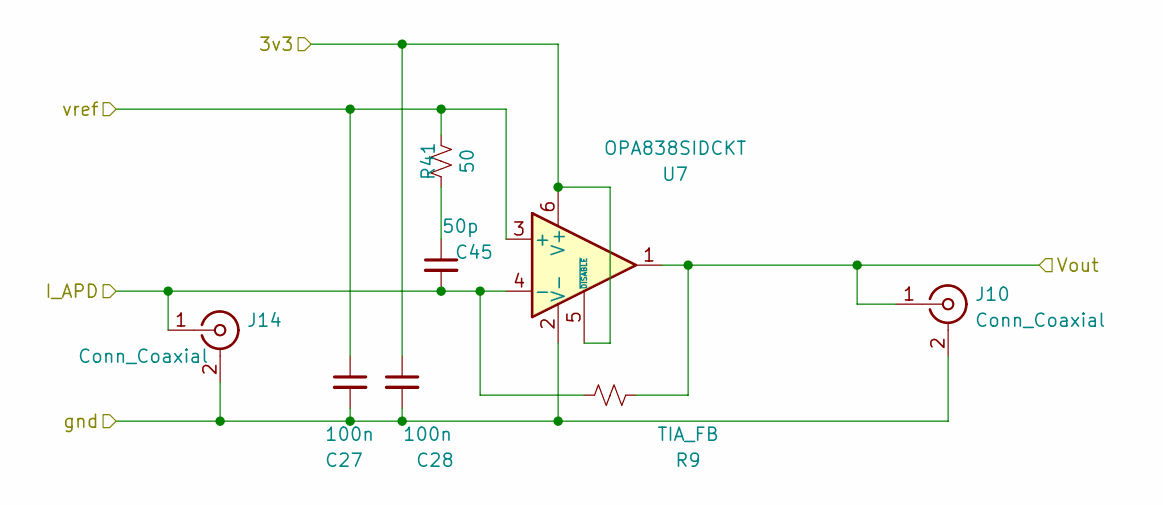
[picture p18: schematic OPA838_TIA.kicad_sch]

Parts:
C27, C28: 100n; C_0603_1608Metric_Pad1.08x0.95mm_HandSolder
C45: 50p; C_0603_1608Metric_Pad1.08x0.95mm_HandSolder
J10, J14: Conn_Coaxial; SMA_Amphenol_901-144_Vertical
R9: TIA_FB; R_0603_1608Metric_Pad0.98x0.95mm_HandSolder
R41: 50; R_0603_1608Metric_Pad0.98x0.95mm_HandSolder
U7: OPA838SIDCKT; SOT-363_SC-70-6_Handsoldering

Connections:
/MAX1191/Vin: J10.1 (In), R9.2, U7.1; also elsewhere on the board
/MAX1191/max_vref: C27.1, R41.2, U7.3 (+); also elsewhere on the board
/TIA/3v3: C28.1, U7.5 (~DISABLE), U7.6 (V+); also elsewhere on the board
/TIA/I_APD: C45.2, J14.1 (In), R9.1, U7.4 (-); also elsewhere on the board
GND: C27.2, C28.2, J10.2 (Ext), J14.2 (Ext), U7.2 (V-); also elsewhere on the board
unnamed: C45.1, R41.1

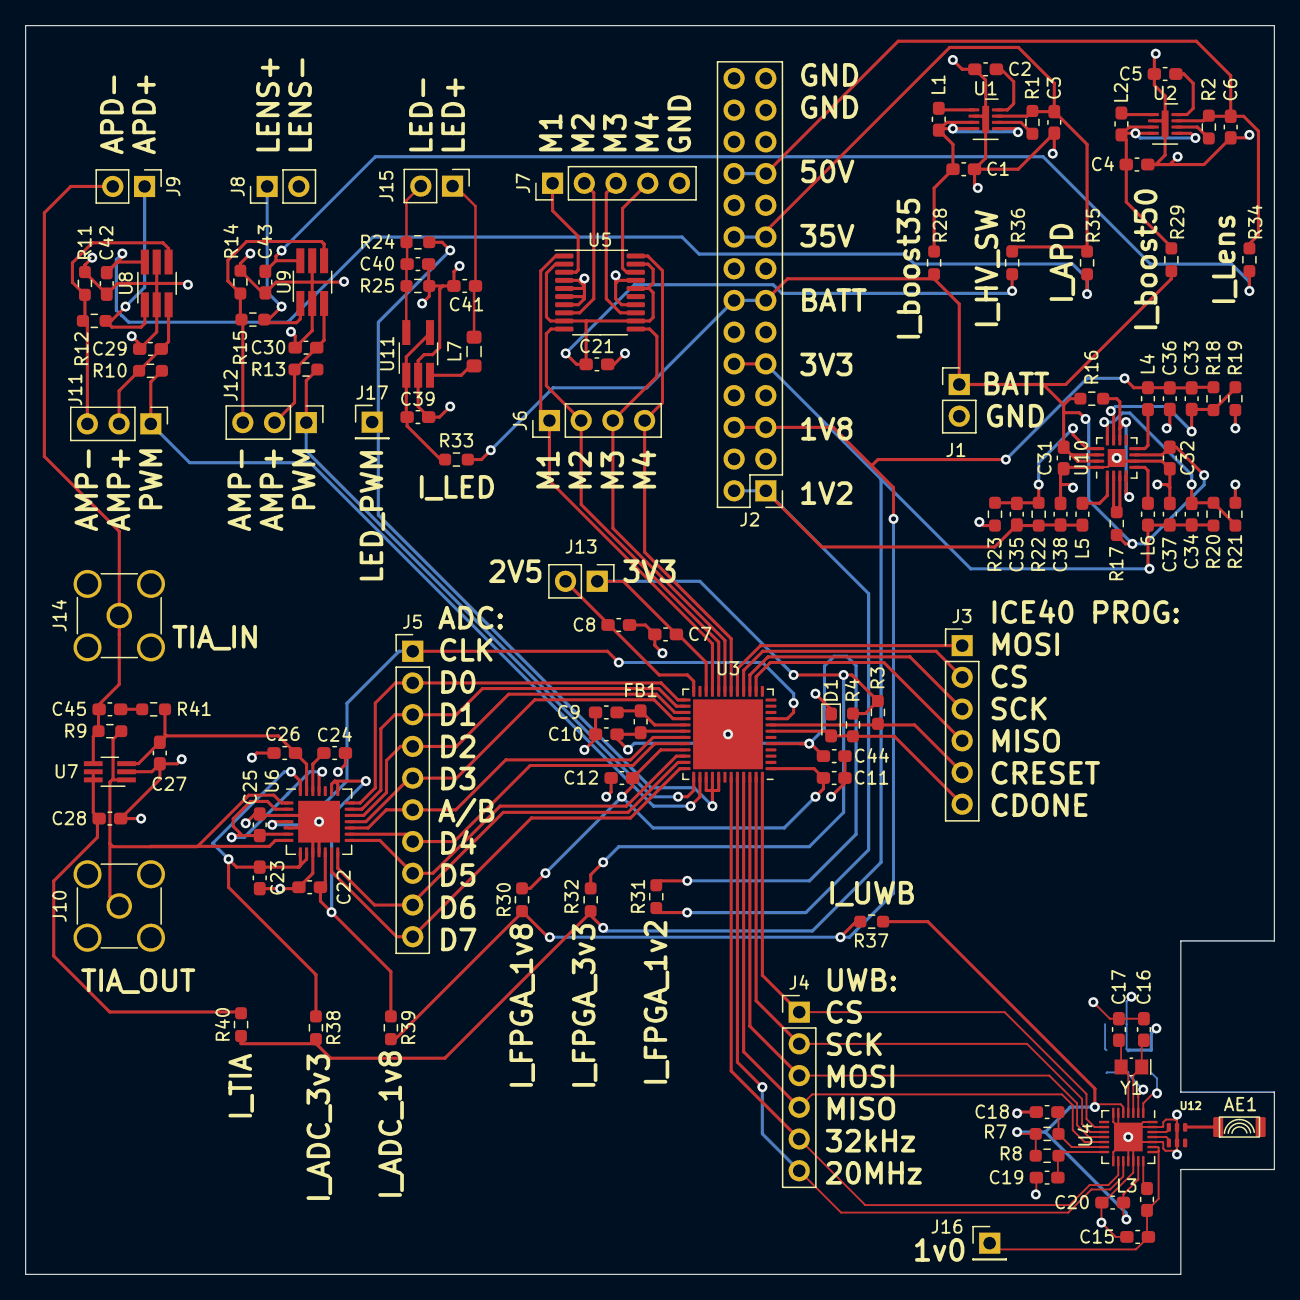
[picture p19: board boards/macro system pcb/controller test board.kicad_pcb from above]

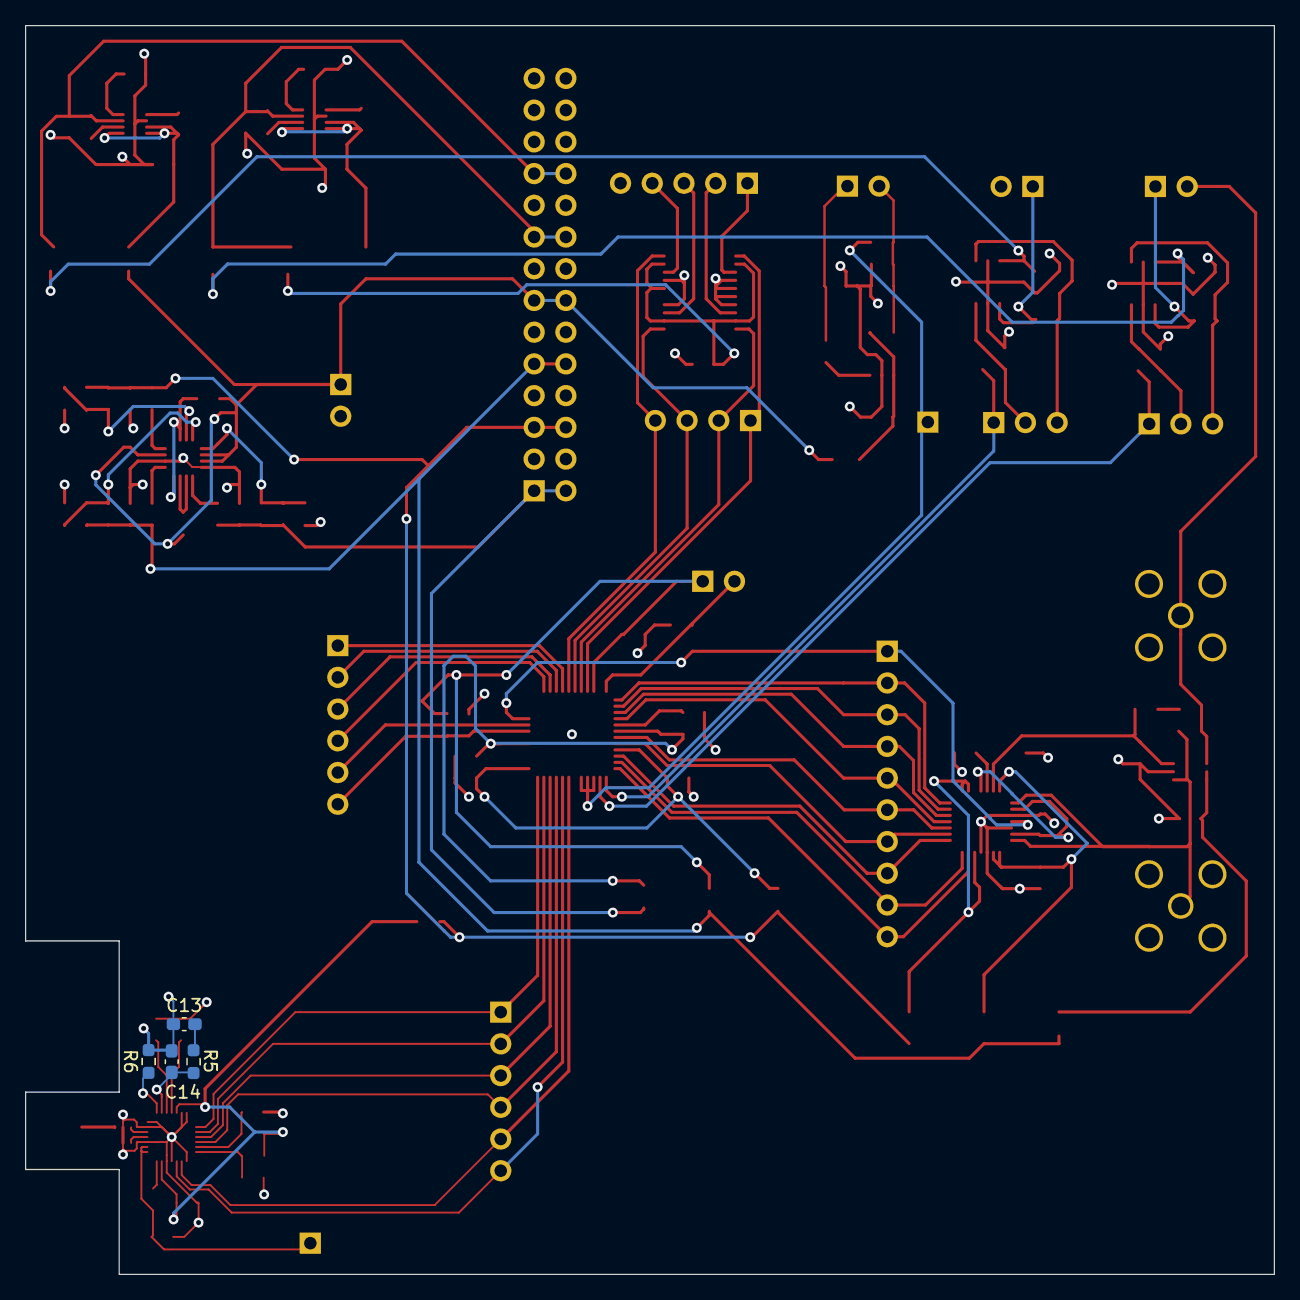
[picture p20: board boards/macro system pcb/controller test board.kicad_pcb from below]

Board: 4 copper layers, 100.0 x 100.0 mm, 124 parts (4 on the bottom side), 96 nets.

Other parts of the board:
C4, C6: 1u; C_0603_1608Metric_Pad1.08x0.95mm_HandSolder
C5: 0.22u; C_0603_1608Metric_Pad1.08x0.95mm_HandSolder
C29, C42: 100n; C_0603_1608Metric_Pad1.08x0.95mm_HandSolder
J11: Conn_01x03; PinHeader_1x03_P2.54mm_Vertical
L2: 15u; L_0603_1608Metric_Pad1.05x0.95mm_HandSolder
R10, R11: 100k; R_0603_1608Metric_Pad0.98x0.95mm_HandSolder
R12: 3M; R_0603_1608Metric_Pad0.98x0.95mm_HandSolder
U2: LT3494; DFN-8-1EP_2x3mm_P0.5mm_EP0.56x2.15mm
U8: ADA4097; TSOT-23-6_HandSoldering

Their connections:
/50v: C6.1, U2.7 (VOUT); also elsewhere on the board
/HVbias/HV_bias: R12.2, U8.1; also elsewhere on the board
/HVbias/PWM_in: J11.1, R10.1; also elsewhere on the board
/HVbias/VHV: C42.1, U8.6 (V+); also elsewhere on the board
/LT3494_boost1/FB: U2.6 (FB); also elsewhere on the board
/LT3494_boost1/Vbatt: C4.1, L2.1, U2.3 (VCC), U2.4 (CTRL), U2.5 (EN); also elsewhere on the board
GND: C4.2, C5.2, C6.2, C29.2, C42.2, R11.1, U2.2 (GND), U2.9 (PAD), U8.2 (V-), U8.5 (~DISABLE); also elsewhere on the board
unnamed: C5.1, U2.8 (CAP)
unnamed: C29.1, J11.2, R10.2, U8.3 (+)
unnamed: J11.3, R11.2, R12.1, U8.4 (-)
unnamed: L2.2, U2.1 (SW)
