williamow/mini-scanning-microscope/(commit log)

2024-07-01 organized existing design files into a more organized structure
    [ADG5234.kicad_sch, HVbias.kicad_sch, ICE40UP5K.kicad_sch, LD APD M mount.kicad_pcb, LD APD M mount.kicad_sch, LED_driver.kicad_sch, LT3494_boost.kicad_sch, MAX1191.kicad_sch]
2024-10-22 made macro system pcb v2
    [ADC.kicad_sch, ADG5234.kicad_sch, HVbias.kicad_sch, ICE40UP5K.kicad_sch, LD APD M mount.kicad_pcb, LD APD M mount.kicad_sch, LD to Mirror path.0001.ipt, LD to Mirror path.ipt]
2025-01-30 create new LD only mount PCB
    [6mm lens mount.0004.ipt, 6mm lens mount.ipt, HVbias.kicad_sch, LD mount.kicad_pcb, LD mount.kicad_sch, adjuster grip.0002.ipt, adjuster grip.ipt, apeature aligner mount.ipt]
2025-09-03 updated physical scanning chassis
    [6mm lens mount.ipt, LD mount.kicad_pcb, LD mount.kicad_sch, LD to Mirror path.ipt, adjustable_collimator.ipt, adjuster grip.ipt, apeature aligner mount.ipt, aperature clip.ipt]
2025-09-03 stopped tracking old optics designs
    [6mm lens mount.0004.ipt, LD to Mirror path.0001.ipt, adjuster grip.0002.ipt, collimator mount.0012.ipt, collimator.0004.ipt, simple aperature.0001.ipt, temp apd reinforcement.0001.ipt]
